ArthurBondar/Tension-Logger-Public/Documents/Datasheets/DB-9 connectors pinout.png

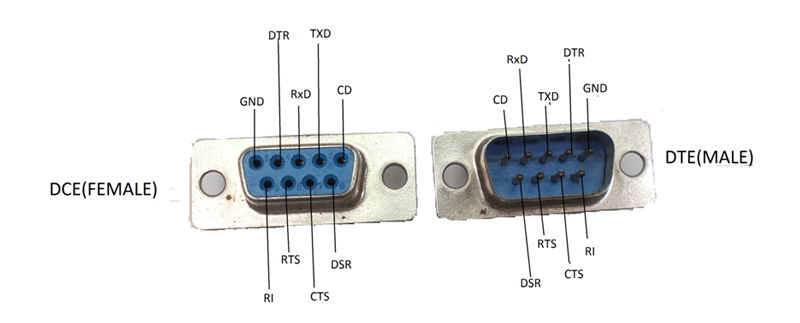
Documents/Datasheets/DB-9 connectors pinout.png
