ArthurBondar/Tension-Logger-Public/Documents/Images/pcbs.jpg

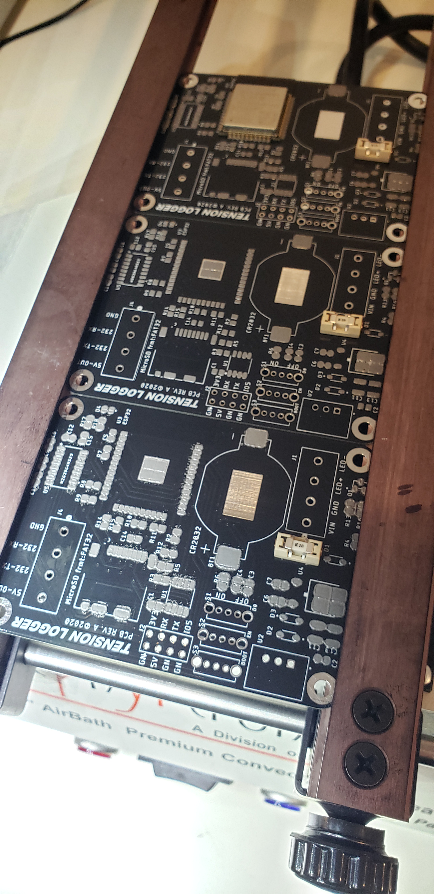
Documents/Images/pcbs.jpg
