ArthurBondar/Tension-Logger-Public/Software/v1.0/README.md

# Blink Example

Starts a FreeRTOS task to blink an LED

See the README.md file in the upper level 'examples' directory for more information about examples.
