ArthurBondar/Tension-Logger-Public/Documents/Datasheets/LEMO4 to rs232.jpg

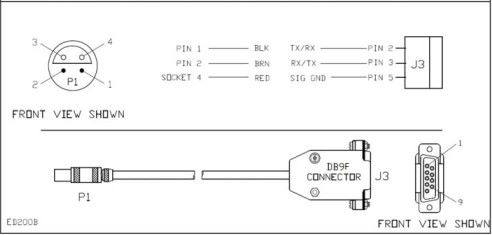
Documents/Datasheets/LEMO4 to rs232.jpg
