ArthurBondar/Tension-Logger-Public/Documents/Datasheets/Tension meter in use.jpg

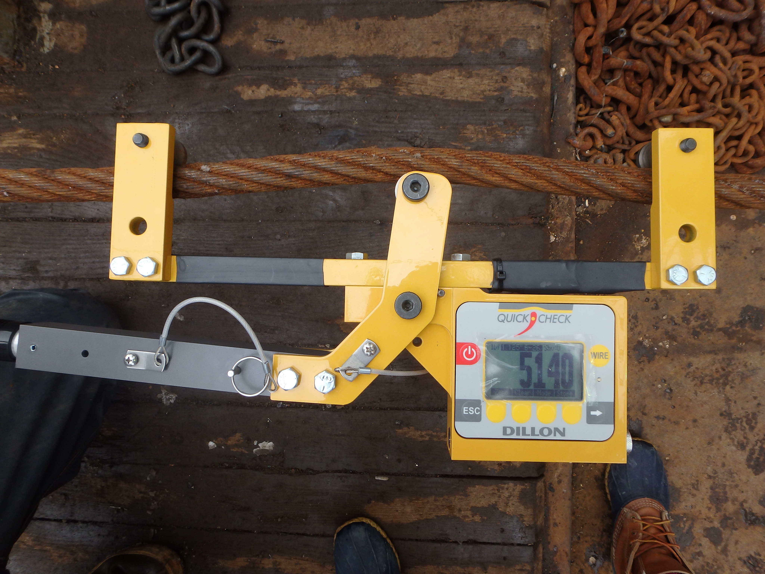
Documents/Datasheets/Tension meter in use.jpg
