ArthurBondar/Tension-Logger-Public/Documents/Images/DB9M_back.png

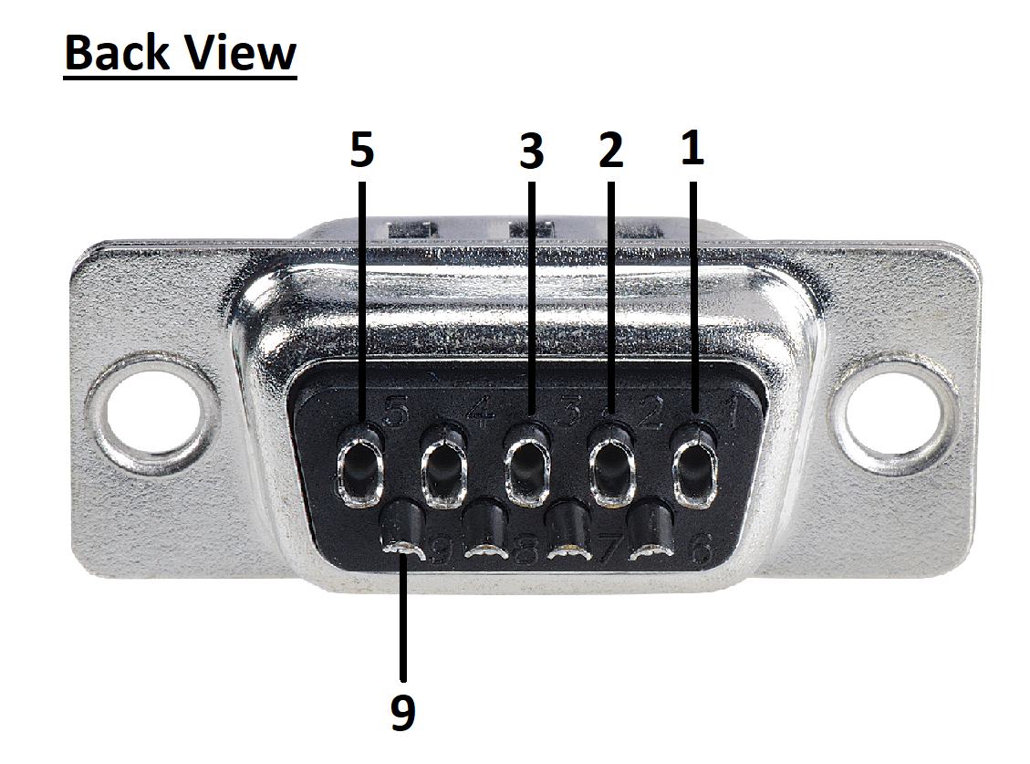
Documents/Images/DB9M_back.png
