ArthurBondar/Tension-Logger-Public/Documents/Images/DB9M_front.jpg

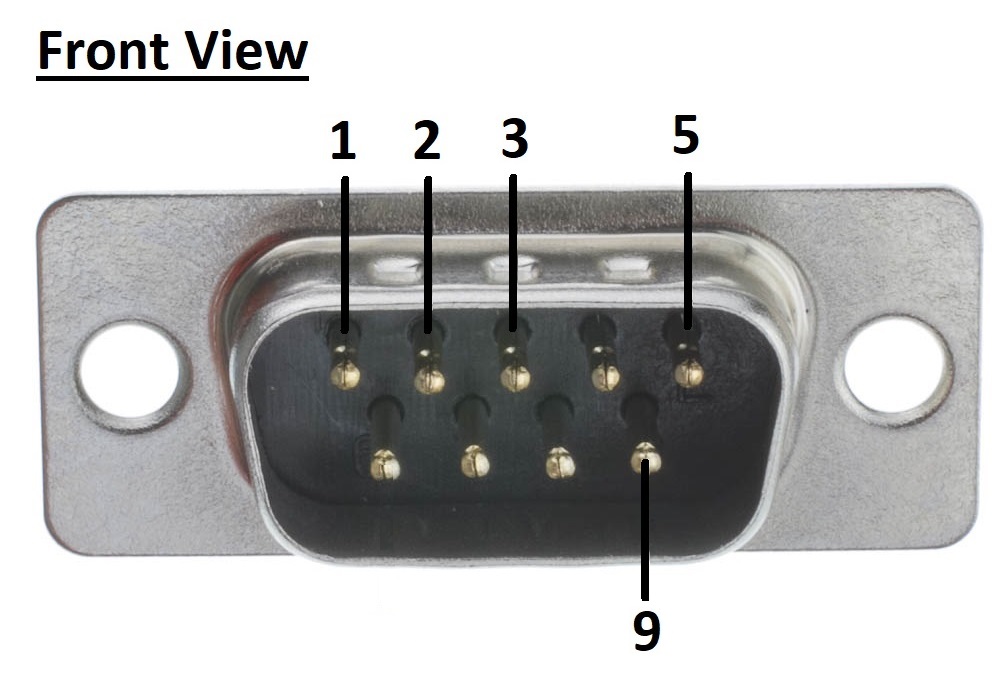
Documents/Images/DB9M_front.jpg
