ArthurBondar/Tension-Logger-Public/Documents/Images/DC jack symbol.png

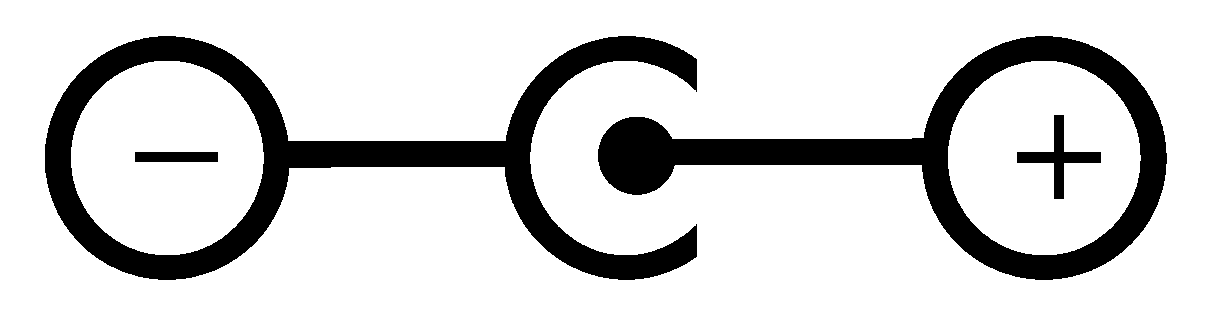
Documents/Images/DC jack symbol.png
