ArthurBondar/Tension-Logger-Public/Documents/Images/DC_Symbol.png

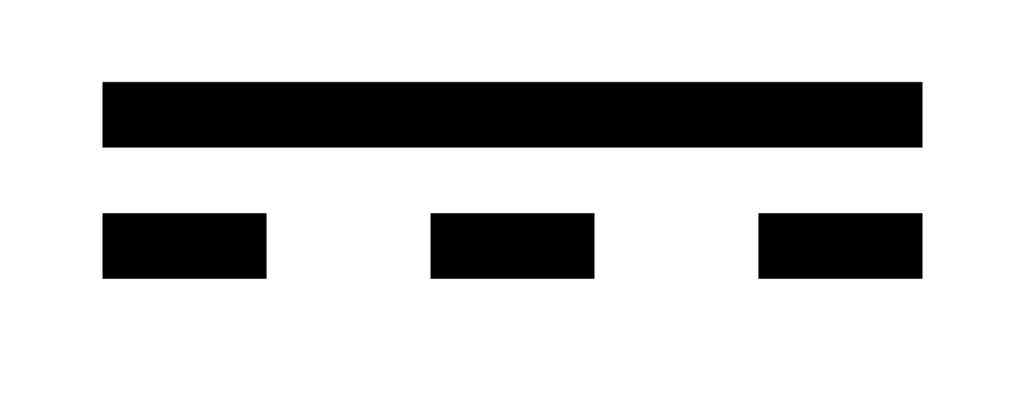
Documents/Images/DC_Symbol.png
