ArthurBondar/Tension-Logger-Public/Documents/Images/Sticker v1.png

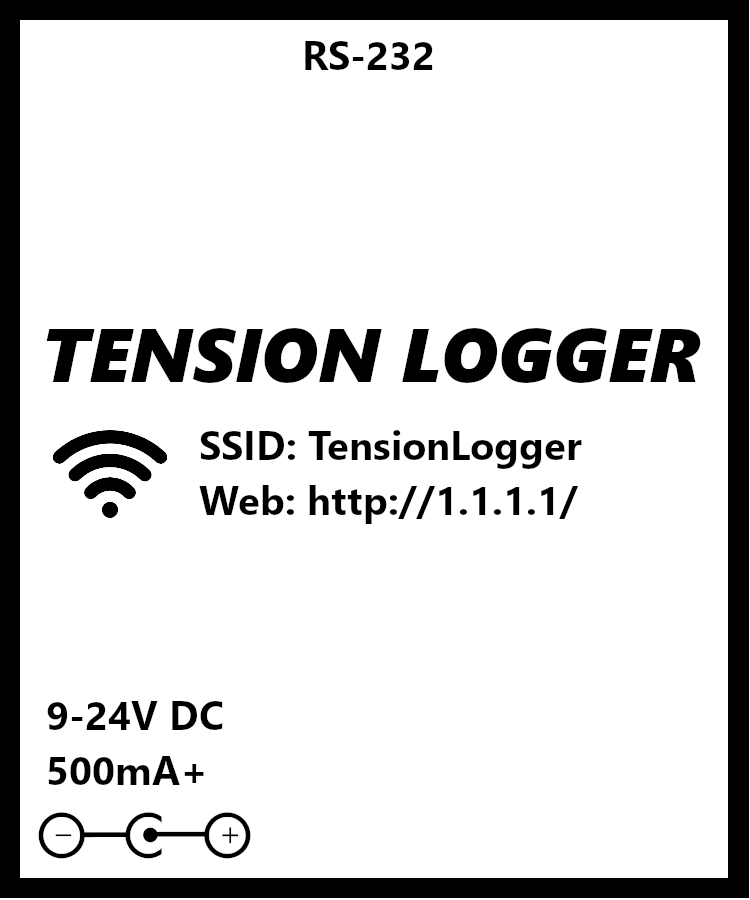
Documents/Images/Sticker v1.png
