ArthurBondar/Tension-Logger-Public/Documents/Images/Tension-Logger PCB.jpg

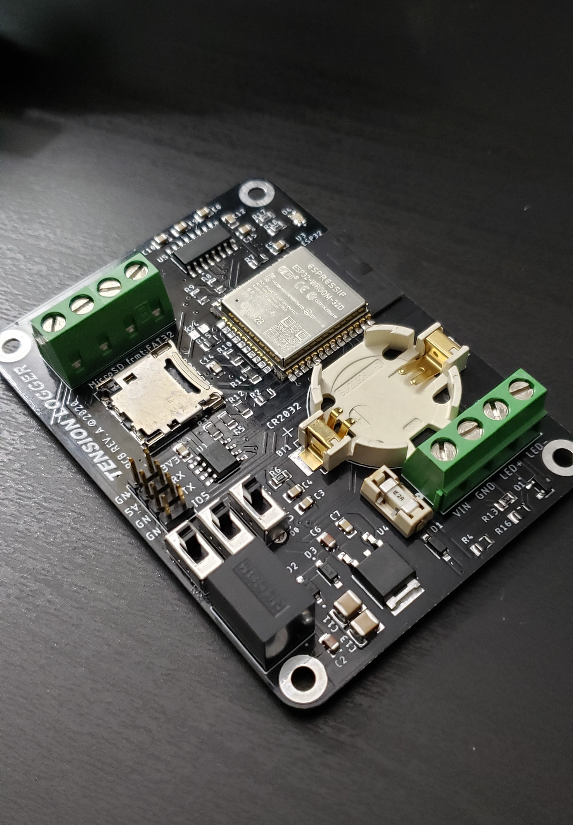
Documents/Images/Tension-Logger PCB.jpg
