ArthurBondar/Tension-Logger-Public/Documents/Images/wifi symbol 2.png

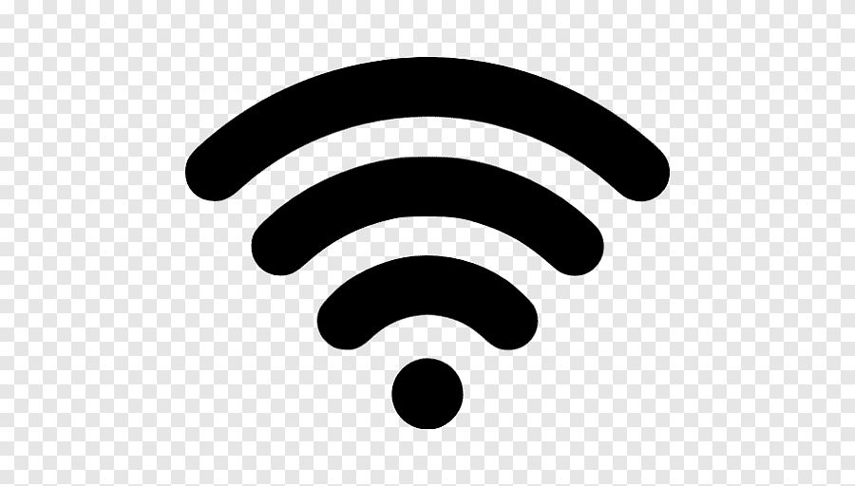
Documents/Images/wifi symbol 2.png
