ArthurBondar/Tension-Logger-Public/Documents/Images/wifi Symbol.jpg

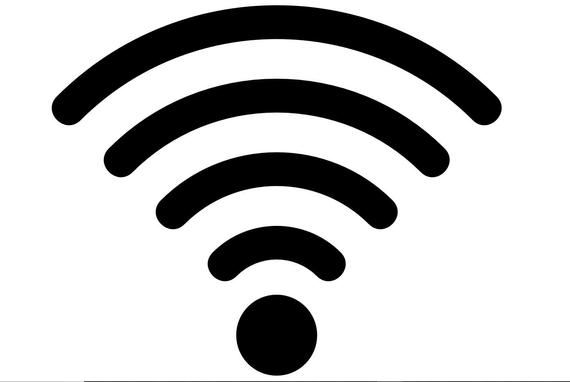
Documents/Images/wifi Symbol.jpg
