ArthurBondar/Tension-Logger-Public/PCB/Tension-Logger Rev. A/model1.PNG

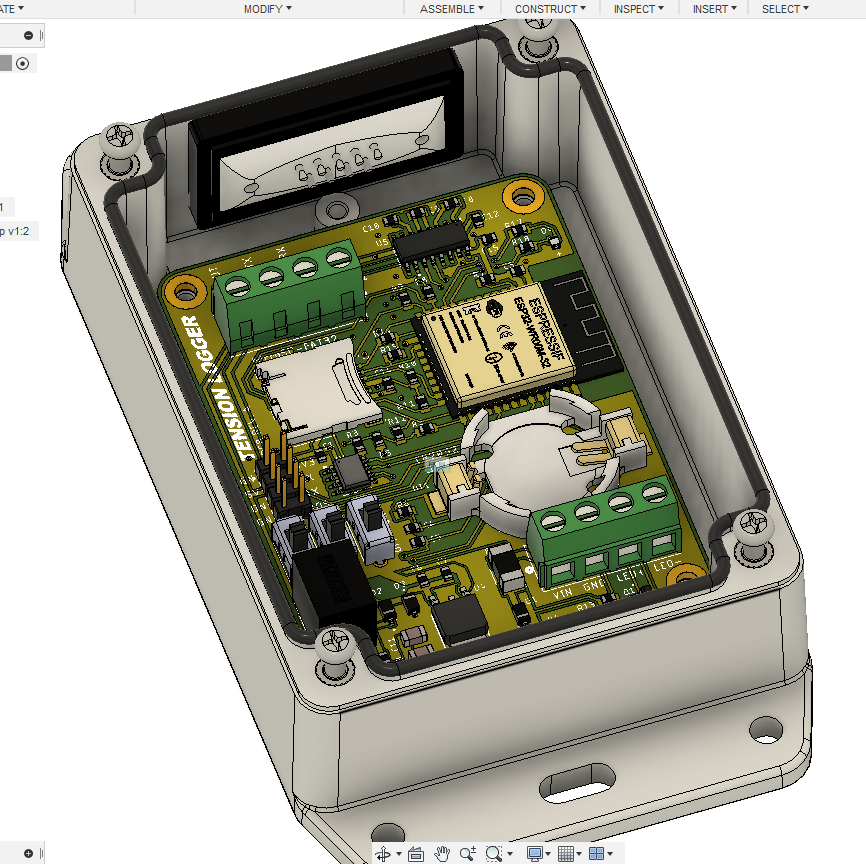
PCB/Tension-Logger Rev. A/model1.PNG
