ArthurBondar/Tension-Logger-Public/Documents/BOM.xlsx

Tension-Logger - September 30, 2020
Parts | Qty. | P/N | Manufacturer | Order Qty. | Price | Total | Link
PCB
ESP32 WiFi 802.11b/g/n, Transceiver Module | 1 | ESP32-WROOM-32D (16MB) | Espressif Systems | 5 | $6.92 | $34.60 | https://www.digikey.ca/en/products/detail/espressif-systems/ESP32-WROOM-32D-16MB/9381718
IC REG LINEAR 3.3V 800MA TO252-3 | 1 | LM1117DTX-3.3/NOPB | Texas Instruments | 5 | $2.18 | $10.90 | https://www.digikey.ca/en/products/detail/texas-instruments/LM1117DTX-3-3-NOPB/366727
DC DC Converter Output 5V - - 1A 8V - 28V Input | 1 | R-78E5.0-1.0 | Recom Power | 4 | $4.94 | $19.76 | https://www.digikey.ca/en/products/detail/recom-power/R-78E5-0-1-0/4930585
Diode Schottky 1A Surface Mount SOD-123 | 3 | 1N5819HW-7-F | Diodes Incorporated | 12 | $0.43 | $5.15 | https://www.digikey.ca/en/products/detail/diodes-incorporated/1N5819HW-7-F/814970
Real Time Clock - I²C, 2-Wire Serial 8-SOIC | 1 | DS3231MZ+ | Maxim Integrated | 4 | $11.66 | $46.64 | https://www.digikey.ca/en/products/detail/maxim-integrated/DS3231MZ/2754396
2/2 Transceiver Full RS232 16-SOIC | 1 | MAX3232CDR | Texas Instruments | 3 | $2.40 | $7.20 | https://www.digikey.ca/en/products/detail/texas-instruments/MAX3232CDR/484770
Battery Holder (Open) Coin, 20.0mm 1 Cell SMD (SMT) Tab | 1 | BU2032SM-HD-G | MPD (Memory Protection Devices) | 4 | $1.30 | $5.20 | https://www.digikey.ca/en/products/detail/mpd-memory-protection-devices/BU2032SM-HD-G/755446
10 (8 + 2) Position Card Connector Secure Digital - microSD™ | 1 | DM3CS-SF | Hirose Electric Co Ltd | 4 | $2.04 | $8.16 | https://www.digikey.ca/en/products/detail/hirose-electric-co-ltd/DM3CS-SF/2602739
AC DC Fuse Board Mount (Cartridge Style Excluded) | 1 | 0154002.DR | Littelfuse Inc. | 4 | $3.50 | $14.00 | https://www.digikey.ca/en/products/detail/littelfuse-inc/0154002-DR/183354
4 Position Wire to Board Terminal Block Horizontal with Board 0.197" (5.00mm) Through Hole | 2 | 282836-4 | TE Connectivity AMP Connectors | 10 | $1.53 | $15.29 | https://www.digikey.ca/en/products/detail/te-connectivity-amp-connectors/282836-4/1826941
Connector Header Through Hole 10 position 0.100" (2.54mm) | 1 | 67997-410HLF | Amphenol ICC (FCI) | 5 | $0.40 | $2.00 | https://www.digikey.ca/en/products/detail/amphenol-icc-fci/67997-410HLF/1878475
Slide Switch SPDT Through Hole | 3 | OS102011MS2QN1 | C&K | 10 | $0.70 | $7.02 | https://www.digikey.ca/en/products/detail/c-k/OS102011MS2QN1/411602
MOSFET N-CH 25V 220MA SOT-23 | 1 | FDV301N | ON Semiconductor | 5 | $0.33 | $1.65 | https://www.digikey.ca/en/products/detail/on-semiconductor/FDV301N/458851
LED GREEN/RED CLEAR 2012 SMD | 1 | APHBM2012SURKCGKC | Kingbright | 10 | $0.44 | $4.44 | https://www.digikey.ca/en/products/detail/kingbright/APHBM2012SURKCGKC/1747491
CAP CER 100UF 10V X5R 1210 | 2 | CL32A107MPVNNNE | Samsung Electro-Mechanics | 10 | $1.21 | $12.09 | https://www.digikey.ca/en/products/detail/samsung-electro-mechanics/CL32A107MPVNNNE/3889022
CAP CER 0.1UF 50V X7R 0805 | 11 | CL21B104KBCNNNC | Samsung Electro-Mechanics | 50 | $0.04 | $1.82 | https://www.digikey.ca/en/products/detail/samsung-electro-mechanics/CL21B104KBCNNNC/3886661
RES SMD 10K OHM 5% 1/8W 0805 | 10 | ERJ-6GEYJ103V | Panasonic Electronic Components | 100 | $0.03 | $3.04 | https://www.digikey.ca/en/products/detail/panasonic-electronic-components/ERJ-6GEYJ103V/83062
RES SMD 100K OHM 1% 1/8W 0805 | 1 | ERJ-6ENF1003V | Panasonic Electronic Components | 10 | $0.10 | $0.99 | https://www.digikey.ca/en/products/detail/panasonic-electronic-components/ERJ-6ENF1003V/111841
RES SMD 49.9 OHM 1% 1/8W 0805 | 3 | ERJ-6ENF49R9V | Panasonic Electronic Components | 10 | $0.09 | $0.92 | https://www.digikey.ca/en/products/detail/panasonic-electronic-components/ERJ-6ENF49R9V/111027
Components
9 Position D-Sub Receptacle, Female Sockets Connector | 1 | A-DF 09 LL-WP | Assmann WSW Components | 2 | $15.24 | $30.48 | https://www.digikey.ca/en/products/detail/assmann-wsw-components/A-DF-09-LL-WP/1089477
9 Position D-Sub Plug, Male Pins Connector | 1 | A-DS09-HOOD-WP | Assmann WSW Components | 2 | $16.35 | $32.70 | https://www.digikey.ca/en/products/detail/assmann-wsw-components/A-DS09-HOOD-WP/1089519
Power Barrel Connector Jack 2.00mm ID (0.079"), 5.50mm OD (0.217") Panel Mount | 1 | 722A | Switchcraft Inc. | 4 | $3.79 | $15.16 | https://www.digikey.ca/en/products/detail/switchcraft-inc/722A/109410
7 MM GREEN PMI W GASKET | 1 | 6071212310F | Dialight | 3 | $9.48 | $28.44 | https://www.digikey.ca/en/products/detail/dialight/6071212310F/2672270
12V AC/DC External Wall Mount (Class II) Adapter Fixed Blade Input | 1 | WR9HE1000CLP-F(R6B) | GlobTek, Inc. | 3 | $13.84 | $41.52 | https://www.digikey.ca/en/products/detail/globtek-inc/WR9HE1000CLP-F-R6B/10187584
FEMALE SCREWLOCK 4-40 .312" | 2 | SFSO4401NR | NorComp Inc. | 4 | $0.42 | $1.70 | https://www.digikey.ca/en/products/detail/norcomp-inc/SFSO4401NR/1766338
9 Position D-Sub Plug, Male Pins Connector | 1 | DE09P064TXLF | Amphenol ICC (FCI) | 3 | $0.79 | $2.37 | https://www.digikey.ca/en/products/detail/amphenol-icc-fci/DE09P064TXLF/1001838
ENCL OWHT ABS 105X75X40 W/FL | 1 | RP1085BF | Hammond Manufacturing | 5 | $14.72 | $73.60 | https://www.digikey.ca/en/products/detail/hammond-manufacturing/RP1085BF/10477552
Coin cell CR2032 | 1 |  | TBD
 |  |  |  |  | Total | $426.84 | CDN
 |  |  |  |  | Per unit | $85.37
