ArthurBondar/Tension-Logger-Public/Documents/Datasheets/ESP32-WROOM-32D_ESP32-WROOM/ESP-WROOM-32_Reference_Design_V1.1/ESP-WROOM-32_Reference_Design_V1.1/05_BOM.xlsx

Item | Quantity | Reference | Specifications
1 | 2 | C1, C2 | 22 pF ± 5%/50 V, 0402
2 | 1 | C3 | 100 pF ± 5%/50 V, 0402
3 | 4 | C4, C9, C10, C19 | 0.1 uF ± 10%/10 V, 0402
4 | 1 | C5 | 10 nF ± 10%/6.3 V, 0402
5 | 1 | C6 | 3.3 nF ± 10%/50 V, 0402
6 | 3 | C11, C18, C20 | 1 uF ± 10%/16 V, 0402
7 | 0 | C12 | NC
8 | 1 | C13 | 10 uF ± 20%/6.3 V, 0603
9 | 1 | C14 | GRM1555C1H4R7BA01D (4.7 pF ± 0.1 pF, 0402)
10 | 1 | C15 | GRM1555C1H2R4CA01D (2.4 pF ± 0.25 pF, 0402)
11 | 2 | C16, C17 | 270 pF ± 5%/50 V, 0402
12 | 1 | L4 | LQP15MN2N4B02D (2.4 nH ± 0.1 nH, 0402)
13 | 1 | D1 | ESD 3.3 V 88D-LCDN, DFN1006
14 | 1 | R1 | 20 K ± 1%/16 W, 0402
15 | 1 | U1 | 40 MHz Crystal, ±10 ppm, 3225
16 | 1 | U2 | ESP32, QFN48_6X6
17 | 1 | U3 | Flash, SOP8-208 mil, GD25Q32
* Please note that Murata is recommended for C14, C15 and L4 for good quality and accuracy.
