ArthurBondar/Tension-Logger-Public/Documents/Datasheets/ESP32-WROOM-32D_ESP32-WROOM/ESP32-WROOM-32D_V2.2_Reference Design/04_BOM List/ESP32-WROOM-32D_V2.2  BOM(V0.9).xls

ESP32-WROOM-32D_V2.2 BOM(V0.9) BOM List
Item | Quantity | Reference | Value | Package | ICs | Description
1 | 2 | C1,C2 | 22pF±10%/6.3V | 0201 | Capacitor | Ceramic Capacitors
2 | 1 | C3 | 100pF±10%/6.3V | 0201 | Capacitor | Ceramic Capacitors
3 | 4 | C4,C9,C10,C19 | 0.1uF±10%/6.3V | 0201 | Capacitor | Ceramic Capacitors
4 | 1 | C5 | 10nF±10%/6.3V | 0201 | Capacitor | Ceramic Capacitors
5 | 1 | C6 | 3.3nF±10%/6.3V | 0201 | Capacitor | Ceramic Capacitors
6 | 3 | C11,C18,C20 | 1uF ±20%/10V | 0201 | Capacitor | Ceramic Capacitors
7 | 1 | C13 | 10uF±20%/6.3V | 0402 | Capacitor | Ceramic Capacitors
9 | 1 | C14 | 2.7pF±0.1pF/50V | 0201 | Capacitor | Ceramic Capacitors
10 | 1 | C15 | 2.0pF±0.1pF/50V | 0201 | Capacitor | Ceramic Capacitors
11 | 1 | L4 | 2.7nH±0.1nH | 0201 | Inductor | Inductor
12 | 1 | L5 | 2.0nH±0.1nH | 0201 | Inductor | Inductor
14 | 1 | R2 | 0R±5% | 0201 | Resistor | Chip Resistors
15 | 1 | R3 | 499R±1% | 0201 | Resistor | Chip Resistors
16 | 1 | R1 | 20K±5% | 0201 | Resistor | Chip Resistors
17 | 1 | D1 | ESD/TVS | SOD882 | ESD/TVS | TVS Diode,3.3V
18 | 1 | U1 | 40MHz±10ppm | CRYS/SMD/4P/3.2X2.5 | Crystal | 40MHz Crystal
19 | 1 | U2 | ESP32-D0WD | QFN48_5x5 | Chip | ESP32 5mm*5mm
20 | 1 | U3 | Flash | SOP8-208mil&150mil | Flash | FLASH(3.3V)
*It is recommended that designers use Murata for C14, C15 and L4 for good quality and accuracy.
