ArthurBondar/Tension-Logger-Public/Documents/Datasheets/ESP32-WROOM-32D_ESP32-WROOM/ESP32-DevKitC-V2 Reference Design/ESP32-DevKitC(ESP32_Core_Board_V2)/05_BOM List/05_ESP32-DevKitC(ESP32_CORE_BOARD_BOM_V2)(V0.9).xlsx

Bill Of Materials August 1,2016 12:17:36
Item | Quantity | Reference | Part
1 | 3 | C1,C18,C20 | 10uF/25V(10%), 0603
2 | 1 | C3 | 22uF/25V(10%), 0603
3 | 2 | C14,C15 | 1nF/50V(10%), 0402
4 | 3 | C9,C16,C19 | 0.1uF/25V(10%), 0402
5 | 1 | C21 | 100uF/6.3V(20%), 1206
6 | 1 | C22 | 1uF/10V(10%), 0402
7 | 1 | D1 | RED LED, 0603
8 | 1 | D2 | ESP32_MODULE
9 | 1 | D3 | 1N5819, DO-214AC
10 | 2 | D4,D5 | ESD05V88D-LC, 0402
11 | 1 | J1 | I42-0531-3121, Micro USB(AB)
12 | 2 | J2,J3 | CON19，排针 2.54 mm 间距 （CON19, 2.54 mm pitch pin header)
13 | 2 | Q1,Q2 | S8050(NPN), SOT-23-3
14 | 1 | R2 | 2K(1%), 0402
15 | 1 | R23 | 470R(1%), 0402
16 | 2 | R3,R4 | 51R(1%), 0402
17 | 3 | R11,R21,R22 | 12K(1%), 0402
18 | 3 | R17,R18,R24 | 0R(1%), 0402
19 | 2 | SW1,SW2 | 复位按键，2 脚，3x4x2 (reset button, 2-pin, 3x4x2)
20 | 1 | U1 | silicon labs: CP2102-GM
21 | 1 | U2 | onsemi: NCP1117ST33T3G/AMS1117-3.3 SOT223
22 | 1 |  | PCB
