ArthurBondar/Tension-Logger-Public/Models/2020-10-29_23-20-15/STEP/SOIC8_ONS-M.step

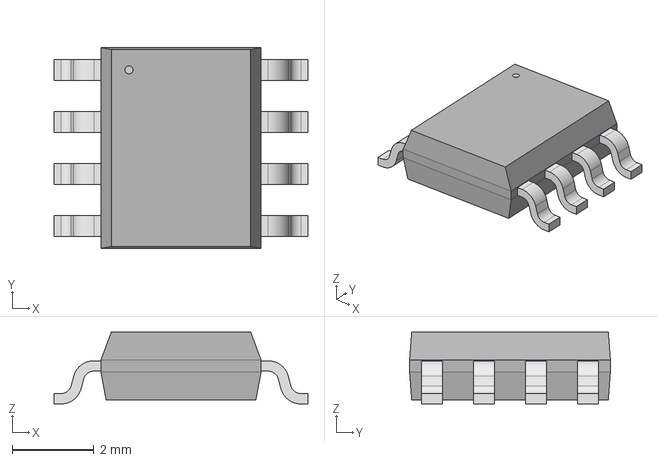
[picture p14: CAD file, 2024-05-27]
Models/2020-10-29_23-20-15/STEP/SOIC8_ONS-M.step
6.20 x 4.90 x 1.75 mm
