ArthurBondar/Tension-Logger-Public/Models/c-282836-4-h-3d.stp

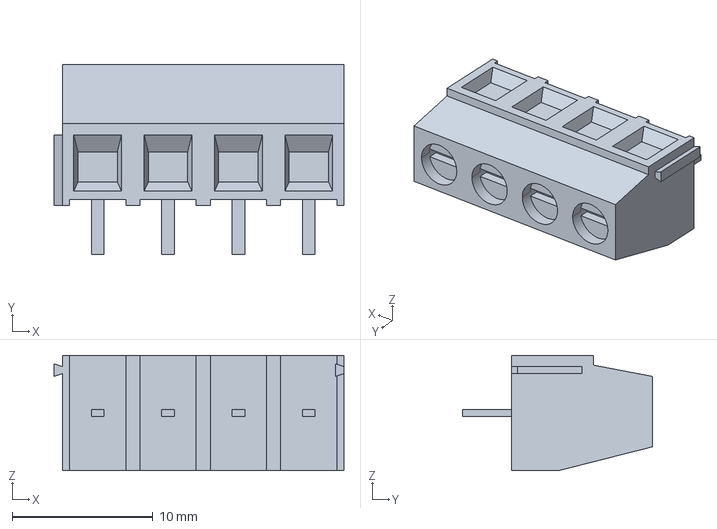
[picture p15: CAD file, 2024-05-27]
Models/c-282836-4-h-3d.stp
20.6 x 13.5 x 8.20 mm
