ArthurBondar/Tension-Logger-Public/Models/1551HFL.stp

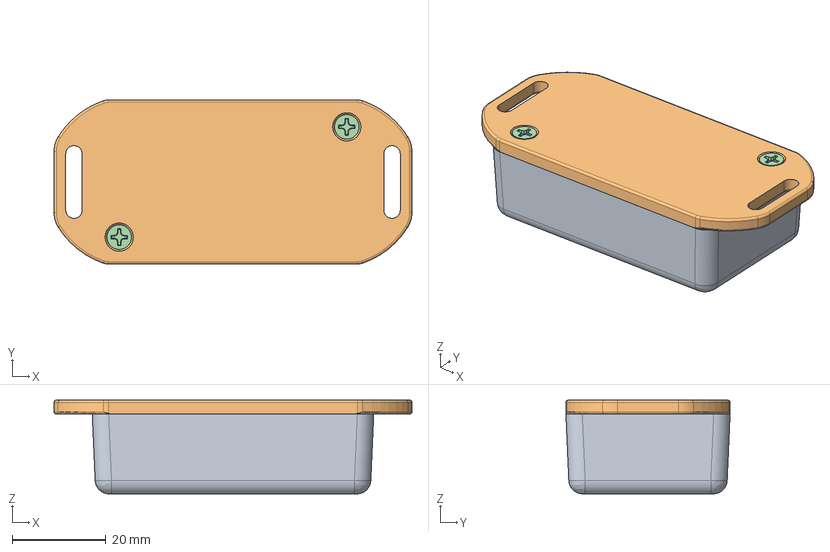
[picture p18: CAD file, 2024-05-27]
Models/1551HFL.stp
76.3 x 35.0 x 20.0 mm
1551H Box
1551H-J Flange Lid
1551H PCB
