ArthurBondar/Tension-Logger-Public/Models/MAX3232CDR.step

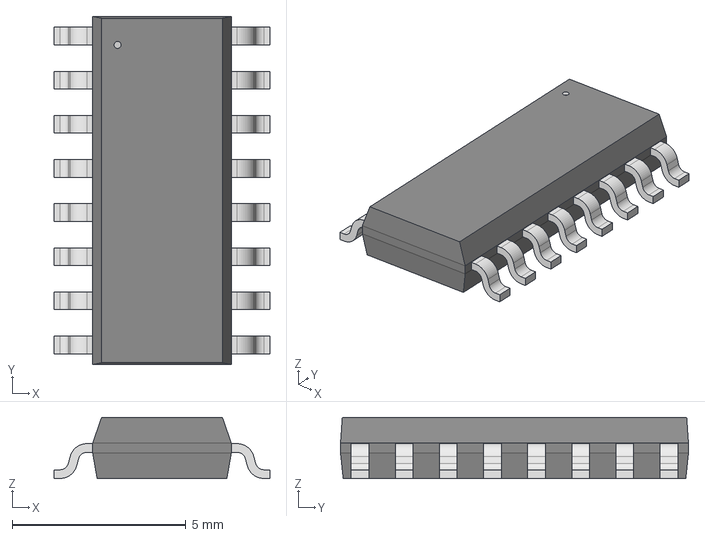
[picture p22: CAD file, 2024-05-27]
Models/MAX3232CDR.step
6.20 x 10.0 x 1.75 mm
