ArthurBondar/Tension-Logger-Public/Models/esp-wroom-32.stp

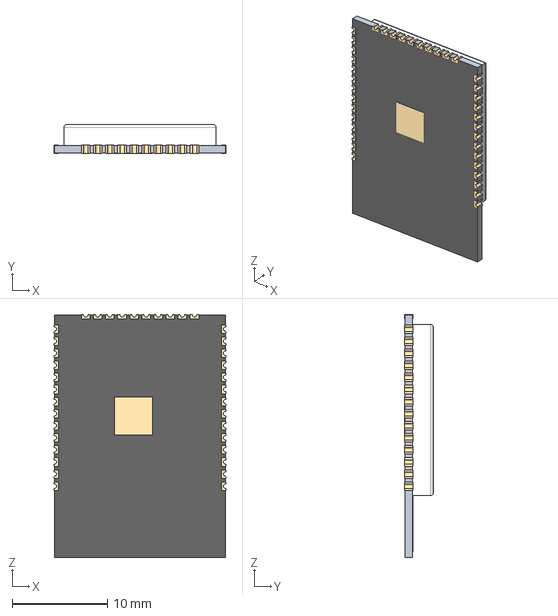
[picture p23: CAD file, 2024-05-27]
Models/esp-wroom-32.stp
18.1 x 3.04 x 25.5 mm
