ArthurBondar/Tension-Logger-Public/Models/1591BFLBK.stp

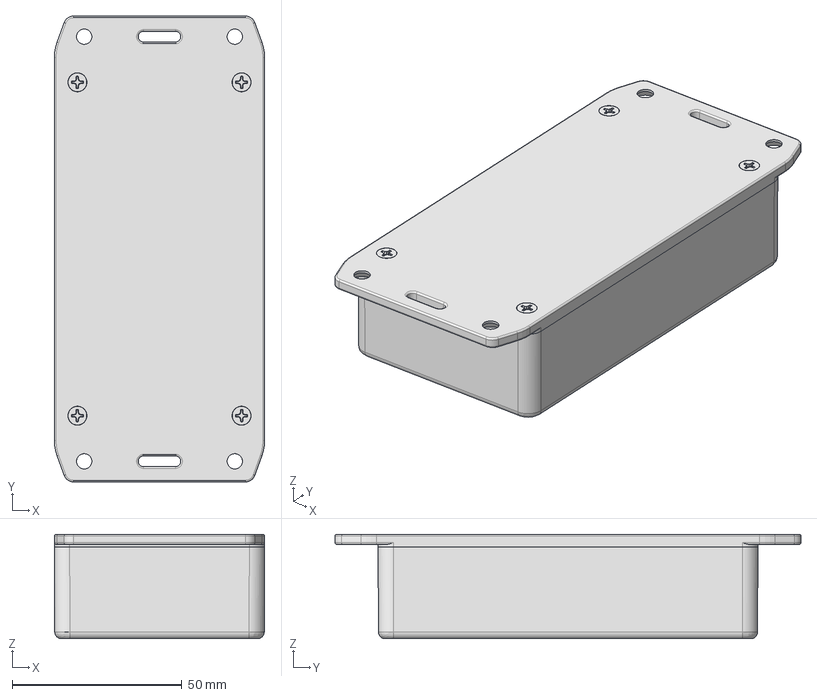
[picture p25: CAD file, 2024-05-27]
Models/1591BFLBK.stp
62.0 x 137.4 x 30.8 mm
1591B Box
1591B Flange Lid
SC500 (screw M3-0.5X 10mm FH) x 4
IN100 (insert M3-0.5X5.75mm BRASS) x 4
