ArthurBondar/Tension-Logger-Public/Models/Headers/Pin Header 2x7 TH Pitch 2.54mm.stp

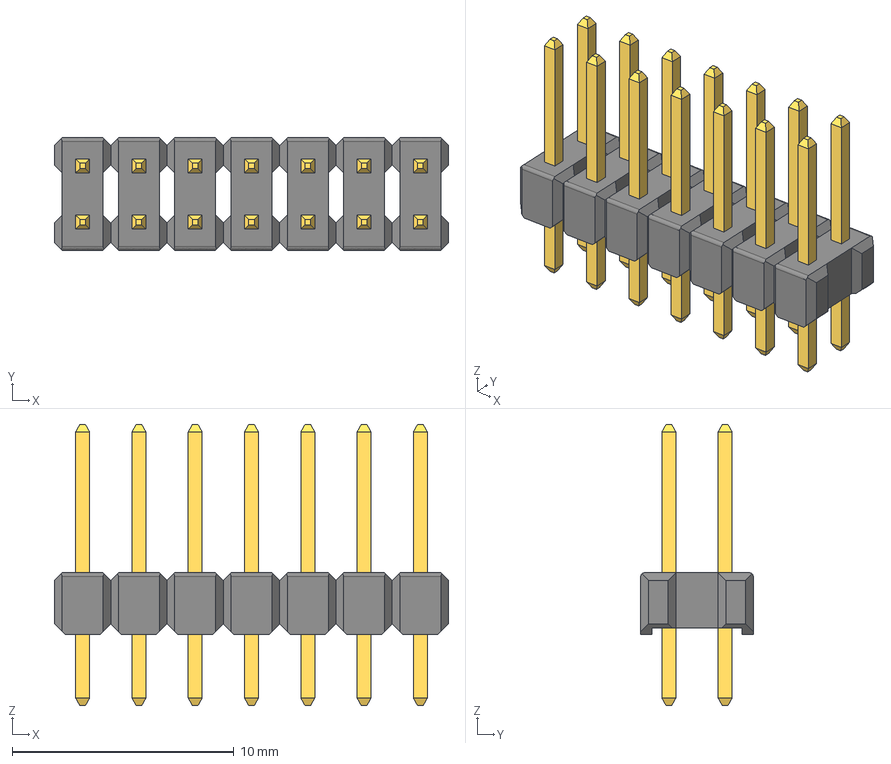
[picture p28: CAD file, 2024-05-27]
Models/Headers/Pin Header 2x7 TH Pitch 2.54mm.stp
17.8 x 5.08 x 12.7 mm
