ArthurBondar/Tension-Logger-Public/Models/Headers/Pin Header 2x4 TH Pitch 2.54mm.stp

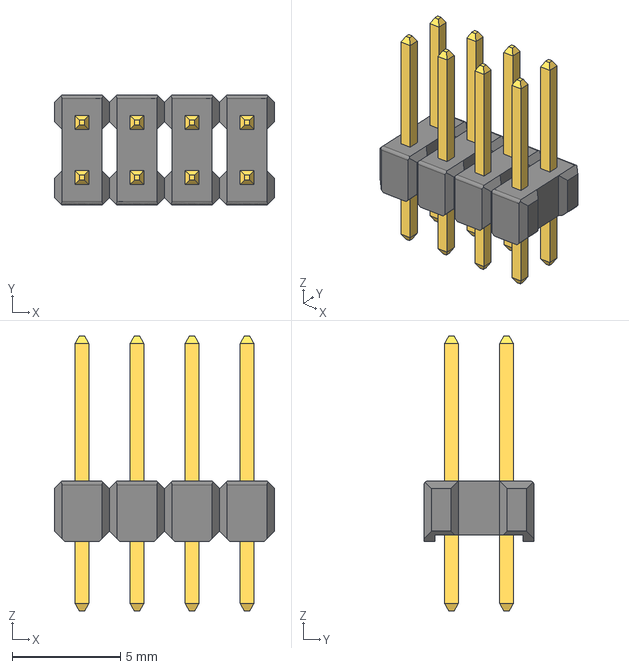
[picture p29: CAD file, 2024-05-27]
Models/Headers/Pin Header 2x4 TH Pitch 2.54mm.stp
10.2 x 5.08 x 12.7 mm
