ArthurBondar/Tension-Logger-Public/Models/SOT23-3_ONS.step

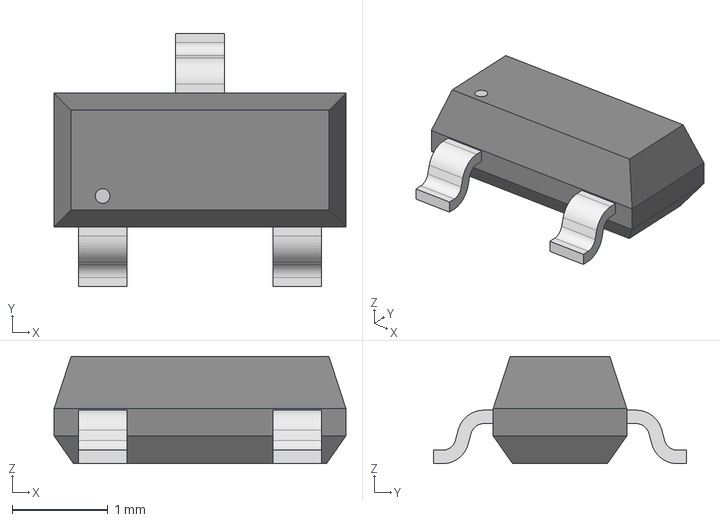
[picture p30: CAD file, 2024-05-27]
Models/SOT23-3_ONS.step
3.05 x 2.64 x 1.12 mm
