ArthurBondar/Tension-Logger-Public/Models/BU2032SM-HD-G.STEP

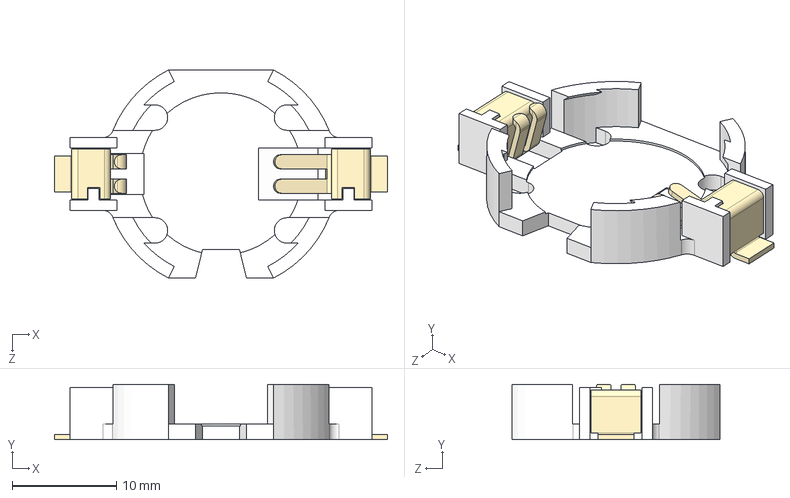
[picture p32: CAD file, 2024-05-27]
Models/BU2032SM-HD-G.STEP
32.0 x 5.30 x 20.0 mm
