ArthurBondar/Tension-Logger-Public/Models/APHBM2012.STEP

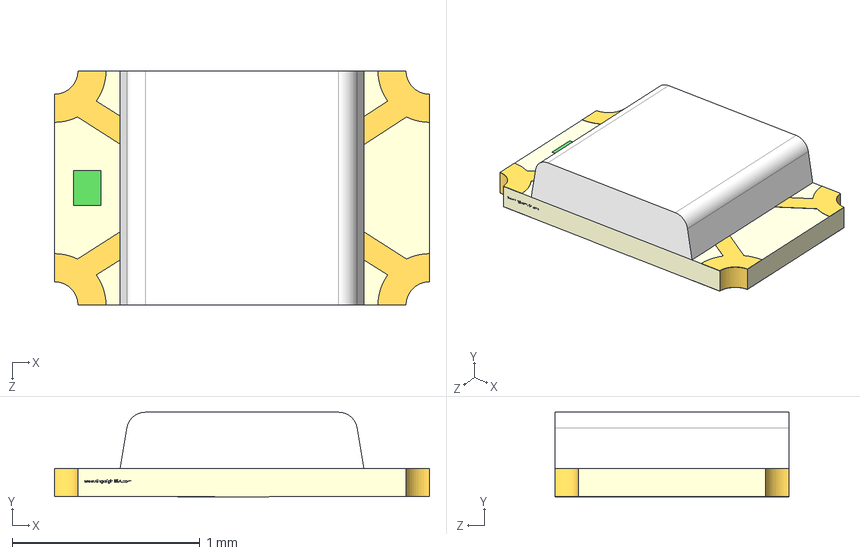
[picture p34: CAD file, 2024-05-27]
Models/APHBM2012.STEP
2.00 x 0.451 x 1.25 mm
