ArthurBondar/Tension-Logger-Public/Models/Headers/Pin Header 2x8 TH Pitch 2.54mm.stp

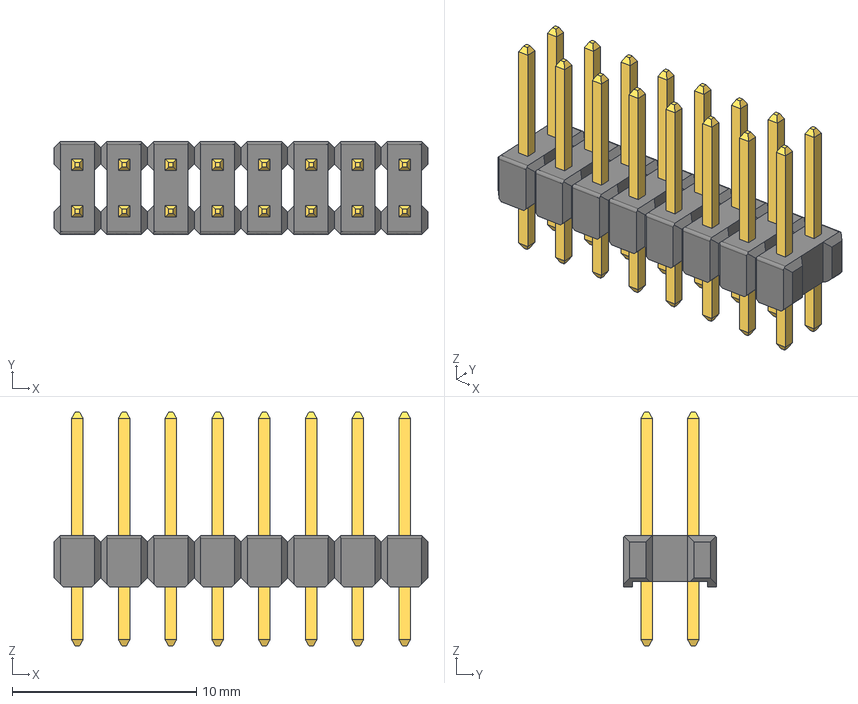
[picture p35: CAD file, 2024-05-27]
Models/Headers/Pin Header 2x8 TH Pitch 2.54mm.stp
20.3 x 5.08 x 12.7 mm
