ArthurBondar/Tension-Logger-Public/Models/ds3231M.step

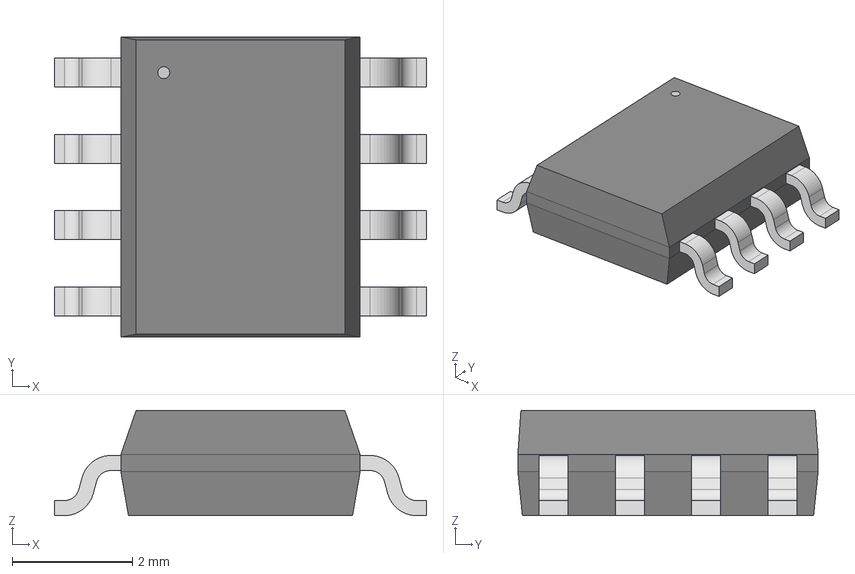
[picture p36: CAD file, 2024-05-27]
Models/ds3231M.step
6.20 x 5.00 x 1.75 mm
