ArthurBondar/Tension-Logger-Public/Models/Headers/Pin Header 2x16 TH Pitch 2.54mm.stp

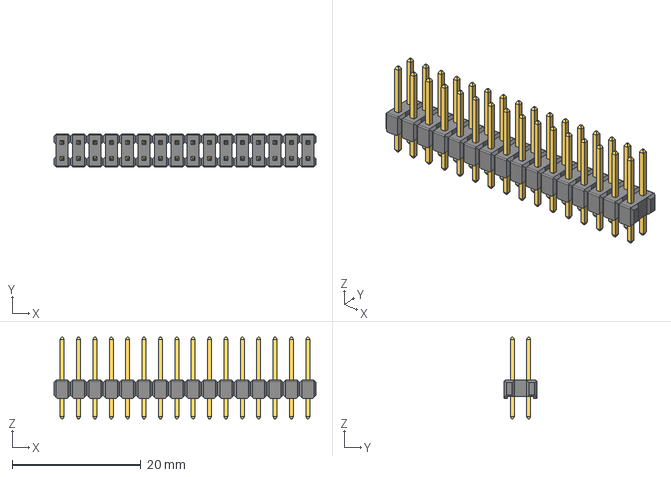
[picture p37: CAD file, 2024-05-27]
Models/Headers/Pin Header 2x16 TH Pitch 2.54mm.stp
40.6 x 5.08 x 12.7 mm
