ArthurBondar/Tension-Logger-Public/Models/R-78E5.0-1.0--3DModel-STEP-1.STEP

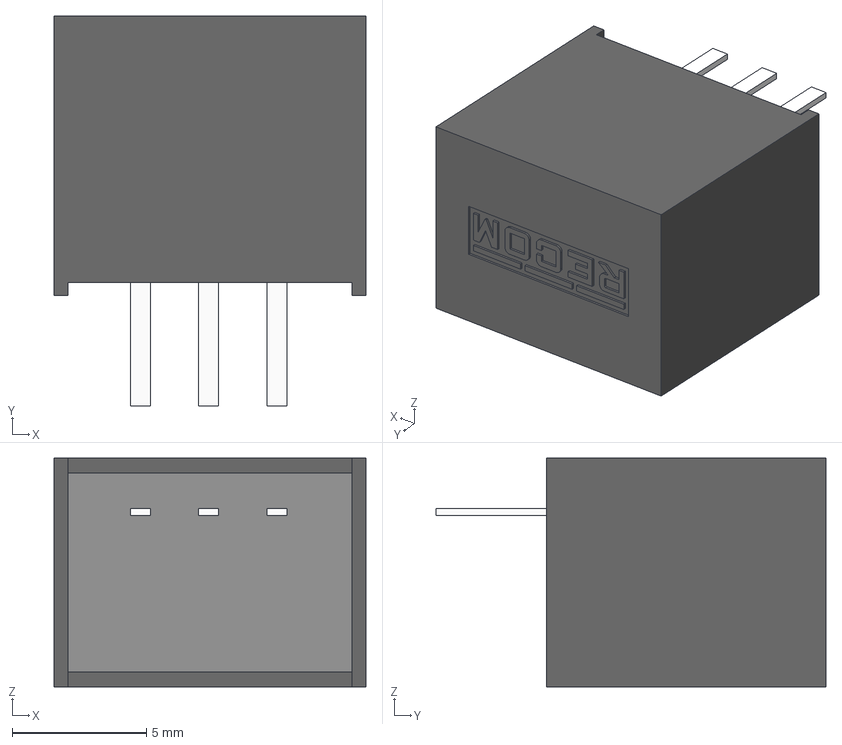
[picture p39: CAD file, 2024-05-27]
Models/R-78E5.0-1.0--3DModel-STEP-1.STEP
11.6 x 14.5 x 8.50 mm
