ArthurBondar/Tension-Logger-Public/Models/DM3CS-SF.step

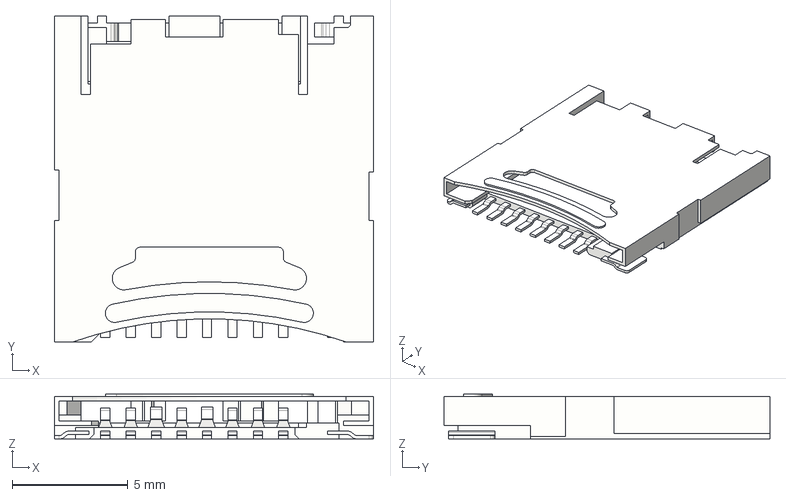
[picture p40: CAD file, 2024-05-27]
Models/DM3CS-SF.step
13.8 x 14.1 x 1.93 mm
