ArthurBondar/Tension-Logger-Public/Models/Jig.stl

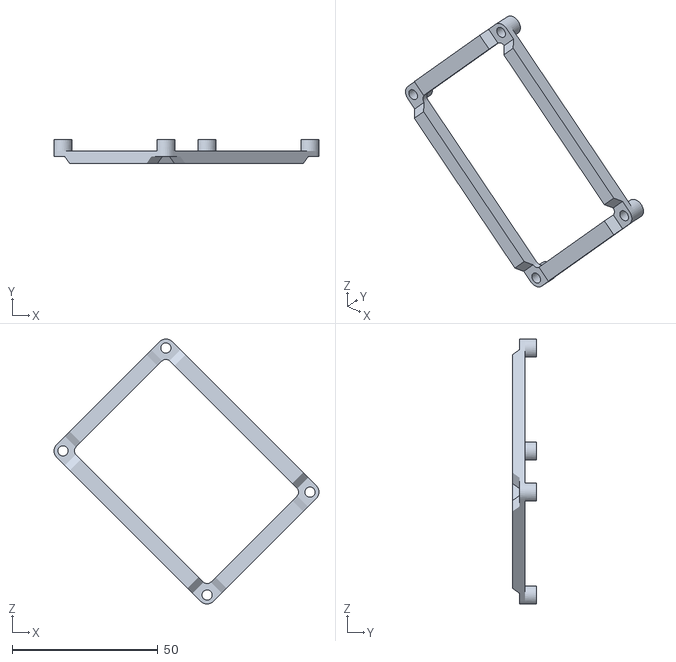
[picture p42: CAD file, 2024-05-27]
Models/Jig.stl
91.1 x 8.40 x 91.1
