ArthurBondar/Tension-Logger-Public/Models/LD09S33E4GX00LF.stp

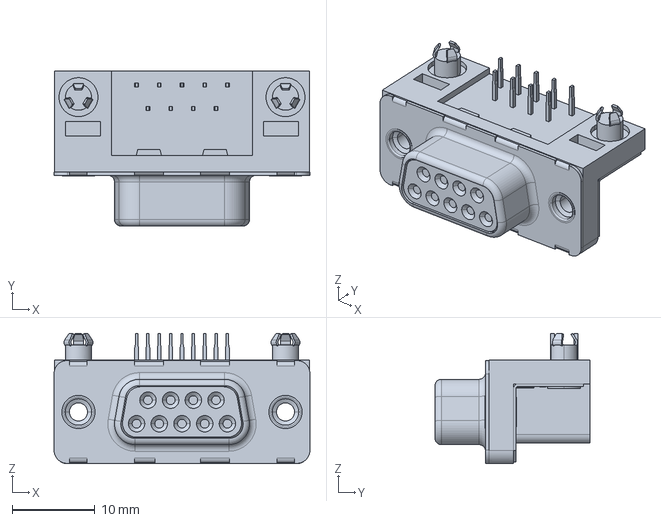
[picture p43: CAD file, 2024-05-27]
Models/LD09S33E4GX00LF.stp
30.9 x 18.7 x 15.8 mm
