ArthurBondar/Tension-Logger-Public/(list of files, cad)

Other CAD files:
Models/2020-10-29_23-20-15/STEP/SOIC8_ONS-L.step
Models/SOIC8_ONS.step
Models/KiCAD-ESP-WROOM-32.step
Models/1591BFLBK.dwg
Models/282836-4.step
Models/785260001.stp
Models/DM3CS-SF.stp
Models/OS102011MS2QN1--3DModel-STEP-1.STEP
