ArthurBondar/Tension-Logger-Public/Software/Tests/ADC cal.xlsx

Voltmeter | ESP32
1.324 | 1.343
1.585 | 1.608
1.662 | 1.683
1.862 | 1.884
1.9 | 1.921
2.22 | 2.24
2.38 | 2.406
2.59 | 2.6
