ArthurBondar/Tension-Logger-Public/Software/Tests/temp/results.csv

'Test Type,Test Description
0,
'Version
1.1.0
'Time Stamp
2020-11-28 12:52:38:833
