ArthurBondar/Tension-Logger-Public/PCB/Tension-Logger Rev. A/Tension-Logger Rev. A.pdf

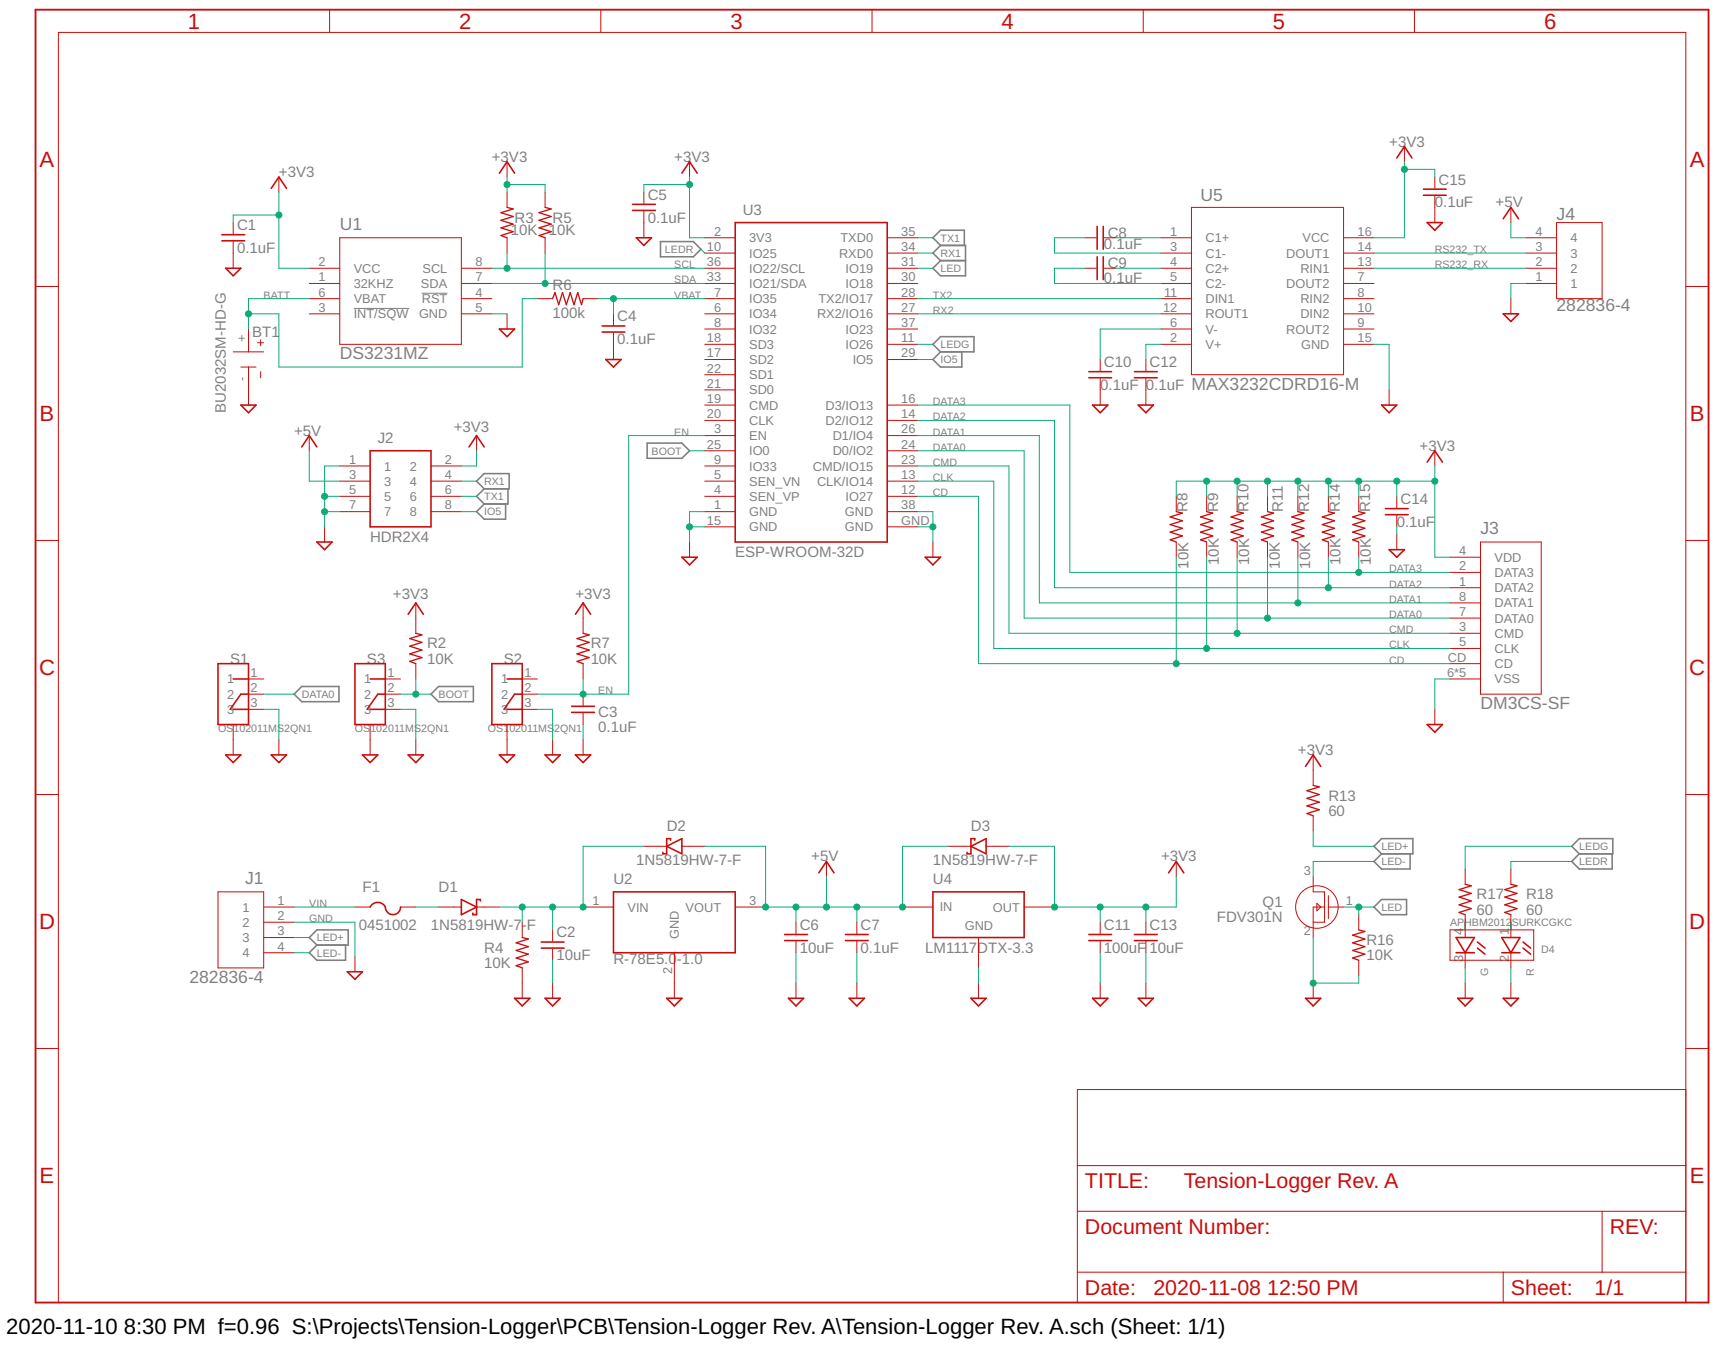
[picture p48: page 1]

Document Number: | REV:

Date: 2020-11-08 12:50 PM | Sheet: 1/1

2020-11-10 8:30 PM f=0.96 S:\Projects\Tension-Logger\PCB\Tension-Logger Rev. A\Tension-Logger Rev. A.sch (Sheet: 1/1)
