ArthurBondar/Tension-Logger-Public/(list of files, drawings)

Other design files:
Documents/Datasheets/ESP32-WROOM-32D_ESP32-WROOM/ESP32-DevKitC-V2 Reference Design/ESP32-DevKitC(ESP32_Core_Board_V2)/01_Schematic/ESP32-DevKitC(ESP32_CORE_BOARD_V2).DSN
Documents/Datasheets/ESP32-WROOM-32D_ESP32-WROOM/ESP32-DevKitC-V2 Reference Design/ESP32-DevKitC(ESP32_Core_Board_V2)/02_PCB Layout/ESP32-DevKitC(ESP32_CORE_BOARD_V2).pcb
Documents/Datasheets/ESP32-WROOM-32D_ESP32-WROOM/ESP32-DevKitC-V4_Reference_Design/02_PCB Layout/ESP32-DevKitC-V4_20171206A.pcb
Documents/Datasheets/ESP32-WROOM-32D_ESP32-WROOM/ESP32-WROOM-32D_V2.2_Reference Design/02_PCB Layout/ESP32-WROOM-32D_V2.2.pcb
Documents/Datasheets/ESP32-WROOM-32D_ESP32-WROOM/ESP32-WROOM-32U_V2.1_Reference Design/02_PCB Layout/ESP32-WROOM-32U_V2.1.pcb
Documents/Datasheets/ESP32-WROOM-32D_ESP32-WROOM/ESP-WROOM-32_Reference_Design_V1.1/ESP-WROOM-32_Reference_Design_V1.1/01_Schematic/SCH_ESP_WROOM_32_6X6.DSN
Documents/Datasheets/ESP32-WROOM-32D_ESP32-WROOM/ESP-WROOM-32_Reference_Design_V1.1/ESP-WROOM-32_Reference_Design_V1.1/02_PCB Layout/ESP32_MODULE_6x6_A.pcb
