ArthurBondar/Tension-Logger-Public/PCB/Tension-Logger Rev. A/Tension-Logger Rev. A.brd

## EAGLE design PCB/Tension-Logger Rev. A/Tension-Logger Rev. A.brd (2024-05-27)

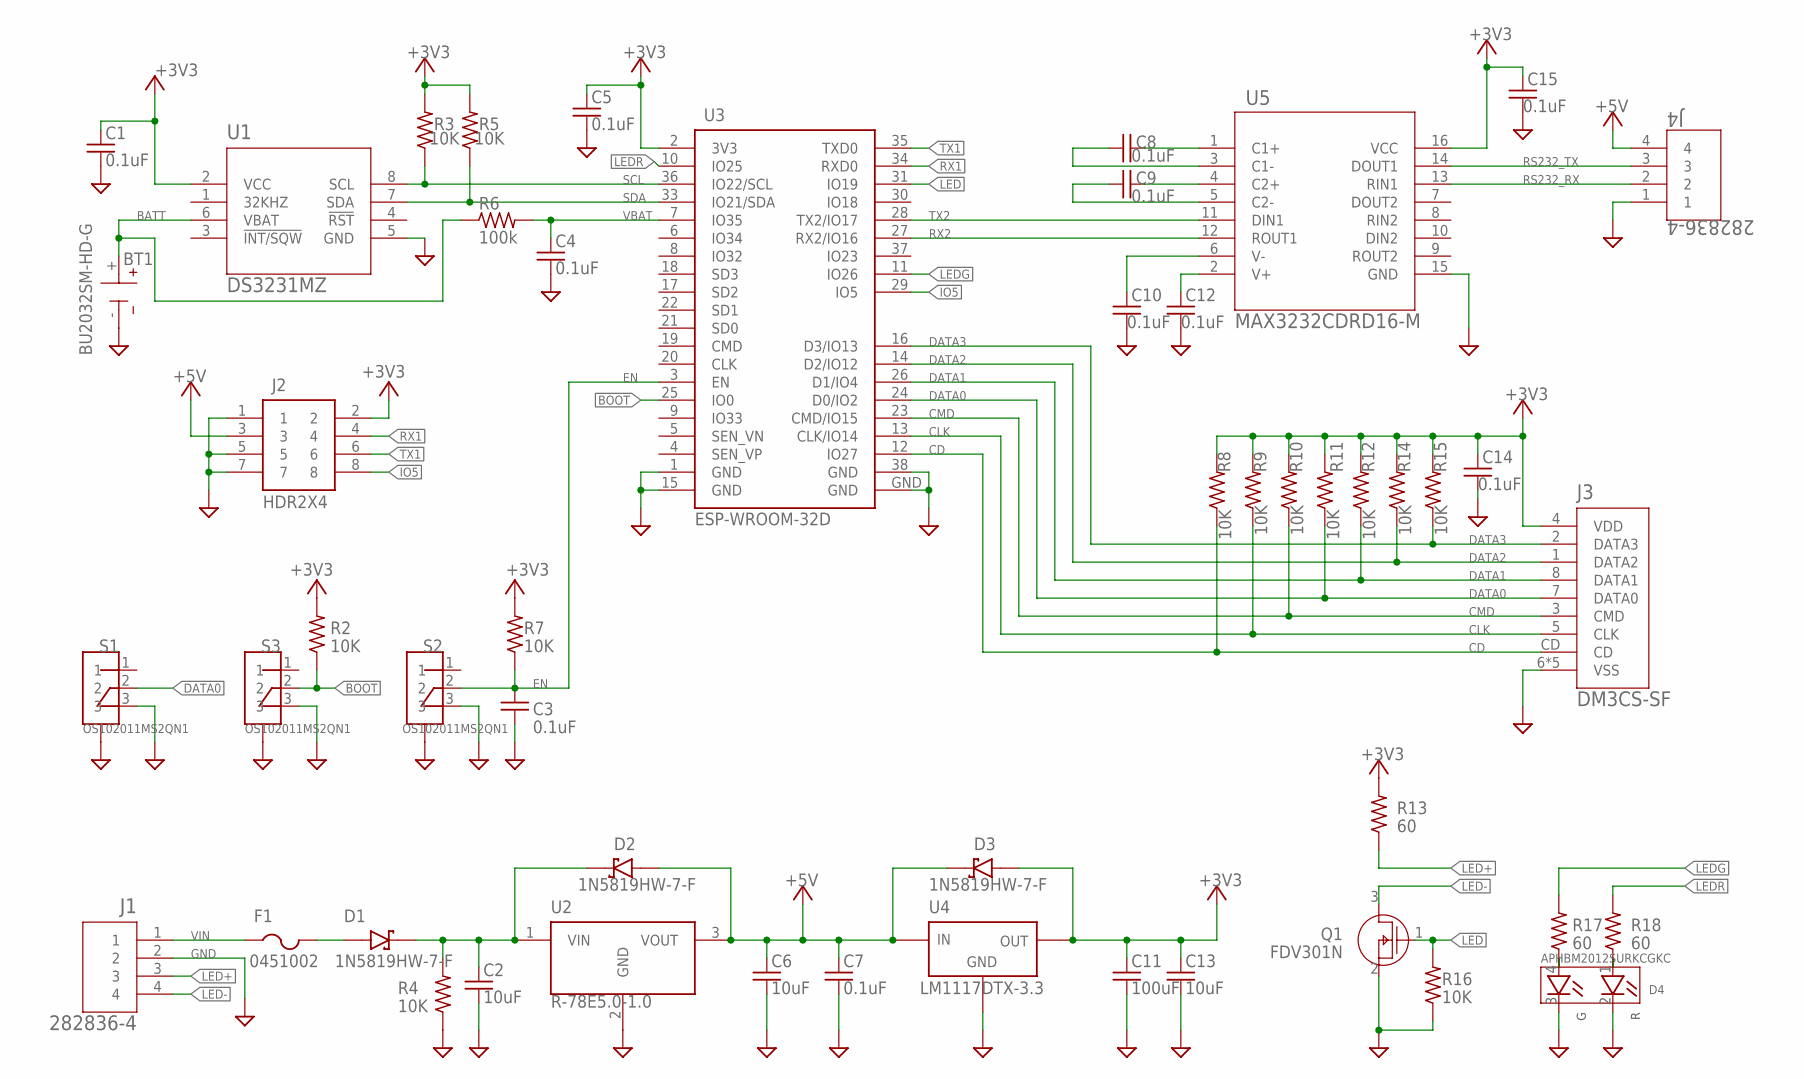
[picture p49: schematic Tension-Logger Rev. A.sch]

Parts:
BT1: BU2032SM-HD-G; BAT_BU2032SM-HD-G
C1, C3, C4, C5, C7, C8, C9, C10, C12, C14, C15: 0.1uF; 0805
C2, C6: 10uF; 0805
C11: 100uF; 1210
C13: 10uF; 1210
D1, D2, D3: 1N5819HW-7-F; SOD3715X145N
D4: APHBM2012SURKCGKC; LED_APHBM2012SURKCGKC
F1: 0451002; FUSC6131X270
J1, J4: 282836-4; 282836-4_TYC
J2: HDR2X4
J3: DM3CS-SF; CONN_3CS-SF
Q1: FDV301N; SOT23-3_ONS
R2, R3, R4, R5, R7, R8, R9, R10, R11, R12, R14, R15, R16: 10K; R0805
R6: 100k; R0805
R13, R17, R18: 60; R0805
S1, S2, S3: OS102011MS2QN1; SW_OS102011MS2QN1
U1: DS3231MZ; 21-0041B_8_MXM-M
U2: R-78E5.0-1.0; CONV_R-78E5.0-1.0
U3: ESP-WROOM-32D; ESP-WROOM-32
U4: LM1117DTX-3.3; TO252
U5: MAX3232CDRD16-M; D16-M

Connections:
+3V3: C1.B (2), C5.B (2), C11.A (1), C13.A (1), C14.A (1), C15.B (2), D3.A, J2.2, J3.4 (VDD), R2.2, R3.2, R5.2, R7.2, R8.2, R9.2, R10.2, R11.2, R12.2, R13.2, R14.2, R15.2, U1.2 (VCC), U3.2 (3V3), U4.TAB (OUT), U5.16 (VCC)
+5V: C6.A (1), C7.A (1), D2.A, D3.C (K), J2.3, J4.4, U2.3 (VOUT), U4.2 (IN)
BATT: BT1.+, R6.1, U1.6 (VBAT)
BOOT: R2.1, S3.2, U3.25 (IO0)
CD: J3.CD, R8.1, U3.12 (IO27)
CLK: J3.5 (CLK), R9.1, U3.13 (CLK/IO14)
CMD: J3.3 (CMD), R10.1, U3.23 (CMD/IO15)
DATA0: J3.7 (DATA0), R11.1, S1.2, U3.24 (D0/IO2)
DATA1: J3.8 (DATA1), R12.1, U3.26 (D1/IO4)
DATA2: J3.1 (DATA2), R14.1, U3.14 (D2/IO12)
DATA3: J3.2 (DATA3), R15.1, U3.16 (D3/IO13)
EN: C3.B (2), R7.1, S2.2, U3.3 (EN)
GND: BT1.-, C1.A (1), C2.B (2), C3.A (1), C4.A (1), C5.A (1), C6.B (2), C7.B (2), C10.B (2), C11.B (2), C12.B (2), C13.B (2), C14.B (2), C15.A (1), D4.2 (C_R), D4.3 (C_G), J1.2, J2.1, J2.5, J2.7, J3.6 (VSS), J3.GND-1 (VSS), J3.GND-2 (VSS), J3.GND-3 (VSS), J3.GND-4 (VSS), J4.1, Q1.2 (S), R4.1, R16.1, S1.3, S1.M1 (CASE), S1.M2 (CASE), S2.3, S2.M1 (CASE), S2.M2 (CASE), S3.3, S3.M1 (CASE), S3.M2 (CASE), U1.5 (GND), U2.2 (GND), U3.1 (GND), U3.15 (GND), U3.38 (GND), U3.GND, U4.1 (GND), U5.15 (GND)
IO5: J2.8, U3.29 (IO5)
LED: Q1.1 (G), R16.2, U3.31 (IO19)
LED+: J1.3, R13.1
LED-: J1.4, Q1.3 (D)
LEDG: R17.2, U3.11 (IO26)
LEDR: R18.2, U3.10 (IO25)
unnamed: D1.A, F1.2
unnamed: D4.1 (A_R), R18.1
unnamed: C2.A (1), D1.C (K), D2.C (K), R4.2, U2.1 (VIN)
unnamed: D4.4 (A_G), R17.1
unnamed: C8.B (2), U5.1 (C1+)
unnamed: C8.A (1), U5.3 (C1-)
unnamed: C9.B (2), U5.4 (C2+)
unnamed: C9.A (1), U5.5 (C2-)
unnamed: C12.A (1), U5.2 (V+)
unnamed: C10.A (1), U5.6 (V-)
RS232_RX: J4.2, U5.13 (RIN1)
RS232_TX: J4.3, U5.14 (DOUT1)
RX1: J2.4, U3.34 (RXD0)
RX2: U3.27 (RX2/IO16), U5.12 (ROUT1)
SCL: R3.1, U1.8 (SCL), U3.36 (IO22/SCL)
SDA: R5.1, U1.7 (SDA), U3.33 (IO21/SDA)
TX1: J2.6, U3.35 (TXD0)
TX2: U3.28 (TX2/IO17), U5.11 (DIN1)
VBAT: C4.B (2), R6.2, U3.7 (IO35)
VIN: F1.1, J1.1

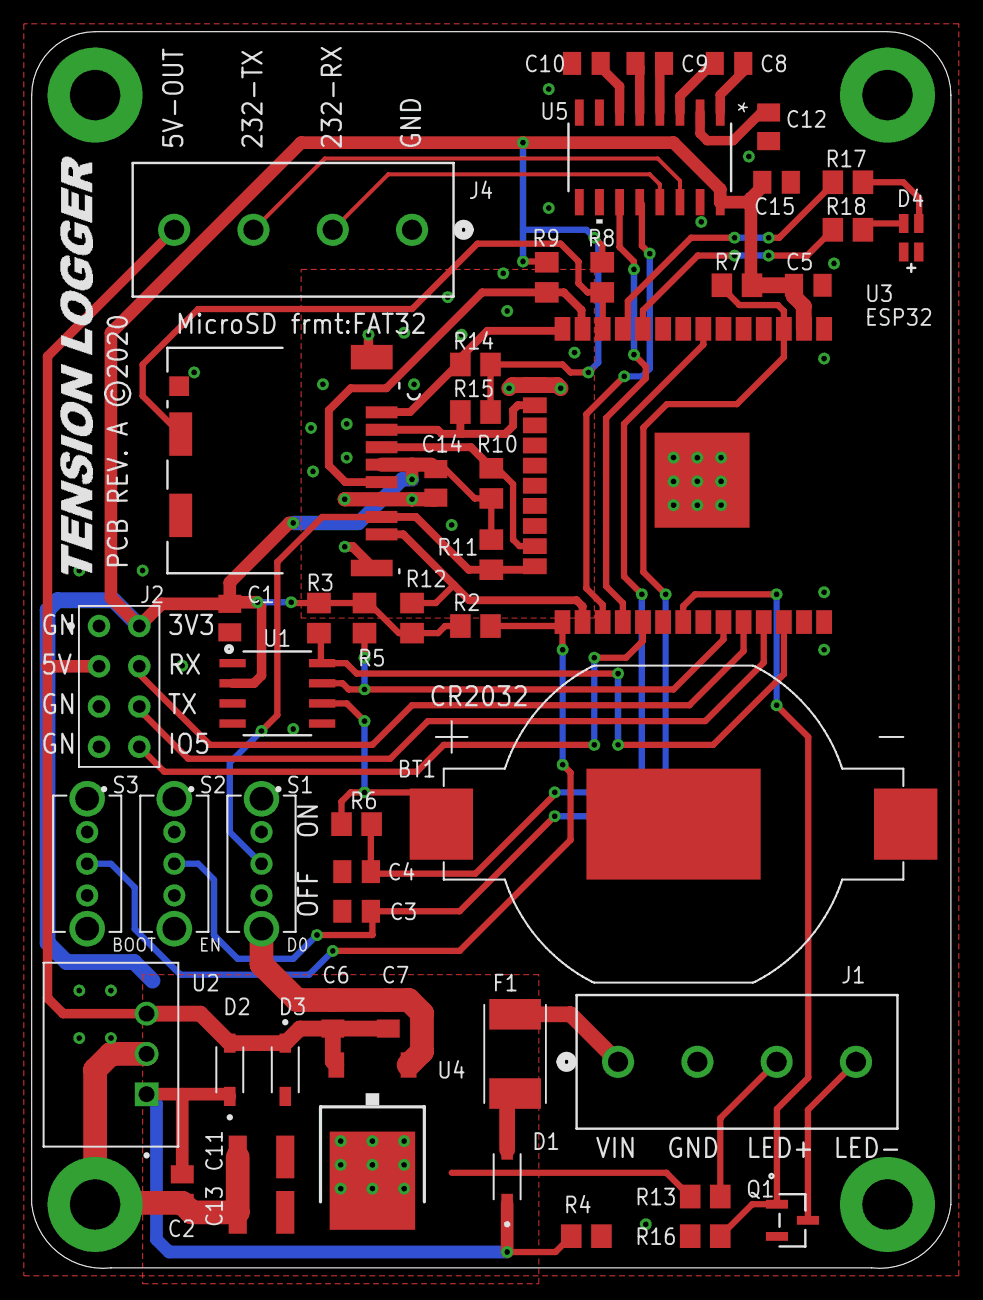
[picture p50: board Tension-Logger Rev. A.brd from above]

Board: 2 copper layers, 58.0 x 78.0 mm, 51 parts (0 on the bottom side), 39 nets.
