ArthurBondar/Tension-Logger-Public/Software/Tests/rtc-test/RTClib.h

/**************************************************************************/
/*!
  @file     RTClib.h

  Original library by JeeLabs http://news.jeelabs.org/code/, released to the
  public domain

  This is a fork of JeeLab's fantastic real time clock library for Arduino.

  For details on using this library with an RTC module like the DS1307, PCF8523,
  or DS3231, see the guide at:
  https://learn.adafruit.com/ds1307-real-time-clock-breakout-board-kit/overview

  Adafruit invests time and resources providing this open source code,
  please support Adafruit and open-source hardware by purchasing
  products from Adafruit!
*/
/**************************************************************************/

#ifndef _RTCLIB_H_
#define _RTCLIB_H_

#include <Arduino.h>
class TimeSpan;

/** Registers */
#define DS3231_ADDRESS 0x68   ///< I2C address for DS3231
#define DS3231_TIME 0x00      ///< Time register
#define DS3231_ALARM1 0x07    ///< Alarm 1 register
#define DS3231_ALARM2 0x0B    ///< Alarm 2 register
#define DS3231_CONTROL 0x0E   ///< Control register
#define DS3231_STATUSREG 0x0F ///< Status register
#define DS3231_TEMPERATUREREG                                                  \
  0x11 ///< Temperature register (high byte - low byte is at 0x12), 10-bit
       ///< temperature value

/** Constants */
#define SECONDS_PER_DAY 86400L ///< 60 * 60 * 24
#define SECONDS_FROM_1970_TO_2000                                              \
  946684800 ///< Unixtime for 2000-01-01 00:00:00, useful for initialization

/**************************************************************************/
/*!
    @brief  Simple general-purpose date/time class (no TZ / DST / leap
            seconds).

    This class stores date and time information in a broken-down form, as a
    tuple (year, month, day, hour, minute, second). The day of the week is
    not stored, but computed on request. The class has no notion of time
    zones, daylight saving time, or
    [leap seconds](http://en.wikipedia.org/wiki/Leap_second): time is stored
    in whatever time zone the user chooses to use.

    The class supports dates in the range from 1 Jan 2000 to 31 Dec 2099
    inclusive.
*/
/**************************************************************************/
class DateTime {
public:
  DateTime(uint32_t t = SECONDS_FROM_1970_TO_2000);
  DateTime(uint16_t year, uint8_t month, uint8_t day, uint8_t hour = 0,
           uint8_t min = 0, uint8_t sec = 0);
  DateTime(const DateTime &copy);
  DateTime(const char *date, const char *time);
  DateTime(const __FlashStringHelper *date, const __FlashStringHelper *time);
  DateTime(const char *iso8601date);
  bool isValid() const;
  char *toString(char *buffer);

  /*!
      @brief  Return the year.
      @return Year (range: 2000--2099).
  */
  uint16_t year() const { return 2000 + yOff; }
  /*!
      @brief  Return the month.
      @return Month number (1--12).
  */
  uint8_t month() const { return m; }
  /*!
      @brief  Return the day of the month.
      @return Day of the month (1--31).
  */
  uint8_t day() const { return d; }
  /*!
      @brief  Return the hour
      @return Hour (0--23).
  */
  uint8_t hour() const { return hh; }

  uint8_t twelveHour() const;
  /*!
      @brief  Return whether the time is PM.
      @return 0 if the time is AM, 1 if it's PM.
  */
  uint8_t isPM() const { return hh >= 12; }
  /*!
      @brief  Return the minute.
      @return Minute (0--59).
  */
  uint8_t minute() const { return mm; }
  /*!
      @brief  Return the second.
      @return Second (0--59).
  */
  uint8_t second() const { return ss; }

  uint8_t dayOfTheWeek() const;

  /* 32-bit times as seconds since 2000-01-01. */
  uint32_t secondstime() const;

  /* 32-bit times as seconds since 1970-01-01. */
  uint32_t unixtime(void) const;

  /*!
      Format of the ISO 8601 timestamp generated by `timestamp()`. Each
      option corresponds to a `toString()` format as follows:
  */
  enum timestampOpt {
    TIMESTAMP_FULL, //!< `YYYY-MM-DDThh:mm:ss`
    TIMESTAMP_TIME, //!< `hh:mm:ss`
    TIMESTAMP_DATE  //!< `YYYY-MM-DD`
  };
  String timestamp(timestampOpt opt = TIMESTAMP_FULL);

protected:
  uint8_t yOff; ///< Year offset from 2000
  uint8_t m;    ///< Month 1-12
  uint8_t d;    ///< Day 1-31
  uint8_t hh;   ///< Hours 0-23
  uint8_t mm;   ///< Minutes 0-59
  uint8_t ss;   ///< Seconds 0-59
};

/** DS3231 SQW pin mode settings */
enum Ds3231SqwPinMode {
  DS3231_OFF = 0x01,            /**< Off */
  DS3231_SquareWave1Hz = 0x00,  /**<  1Hz square wave */
  DS3231_SquareWave1kHz = 0x08, /**<  1kHz square wave */
  DS3231_SquareWave4kHz = 0x10, /**<  4kHz square wave */
  DS3231_SquareWave8kHz = 0x18  /**<  8kHz square wave */
};

/** DS3231 Alarm modes for alarm 1 */
enum Ds3231Alarm1Mode {
  DS3231_A1_PerSecond = 0x0F, /**< Alarm once per second */
  DS3231_A1_Second = 0x0E,    /**< Alarm when seconds match */
  DS3231_A1_Minute = 0x0C,    /**< Alarm when minutes and seconds match */
  DS3231_A1_Hour = 0x08,      /**< Alarm when hours, minutes
                                   and seconds match */
  DS3231_A1_Date = 0x00,      /**< Alarm when date (day of month), hours,
                                   minutes and seconds match */
  DS3231_A1_Day = 0x10        /**< Alarm when day (day of week), hours,
                                   minutes and seconds match */
};
/** DS3231 Alarm modes for alarm 2 */
enum Ds3231Alarm2Mode {
  DS3231_A2_PerMinute = 0x7, /**< Alarm once per minute
                                  (whenever seconds are 0) */
  DS3231_A2_Minute = 0x6,    /**< Alarm when minutes match */
  DS3231_A2_Hour = 0x4,      /**< Alarm when hours and minutes match */
  DS3231_A2_Date = 0x0,      /**< Alarm when date (day of month), hours
                                  and minutes match */
  DS3231_A2_Day = 0x8        /**< Alarm when day (day of week), hours
                                  and minutes match */
};

/**************************************************************************/
/*!
    @brief  RTC based on the DS3231 chip connected via I2C and the Wire library
*/
/**************************************************************************/
class RTC_DS3231 {
public:
  boolean begin(void);
  static void adjust(const DateTime &dt);
  bool lostPower(void);
  static DateTime now();
  static Ds3231SqwPinMode readSqwPinMode();
  static void writeSqwPinMode(Ds3231SqwPinMode mode);
  bool setAlarm1(const DateTime &dt, Ds3231Alarm1Mode alarm_mode);
  bool setAlarm2(const DateTime &dt, Ds3231Alarm2Mode alarm_mode);
  void disableAlarm(uint8_t alarm_num);
  void clearAlarm(uint8_t alarm_num);
  bool alarmFired(uint8_t alarm_num);
  void enable32K(void);
  void disable32K(void);
  bool isEnabled32K(void);
  static float getTemperature(); // in Celcius degree
};

#endif // _RTCLIB_H_
