ArthurBondar/Tension-Logger-Public/(notices)

Notices in the files:
PCB/Tension-Logger Rev. A/Tension-Logger Rev. A.brd:
PCB REV. A ©2020
parts and their libraries:
COPYRIGHT: Copyright (C) 2018 Accelerated Designs. All rights reserved
